aalonsopuig/Brutus_robot/Document/spmodules.png

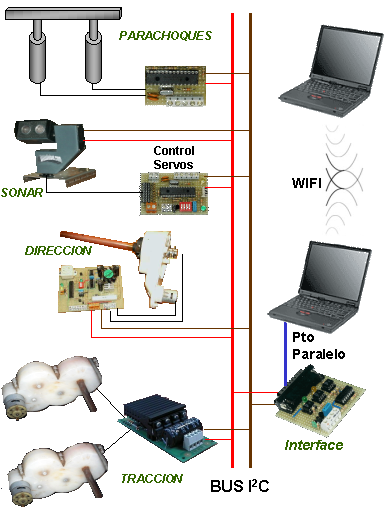
Document/spmodules.png
