aalonsopuig/Brutus_robot/Document/Ruso.jpg

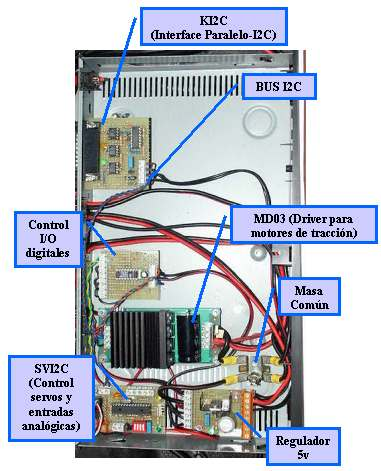
Document/Ruso.jpg
