aalonsopuig/Brutus_robot/Document/brutusprog.png

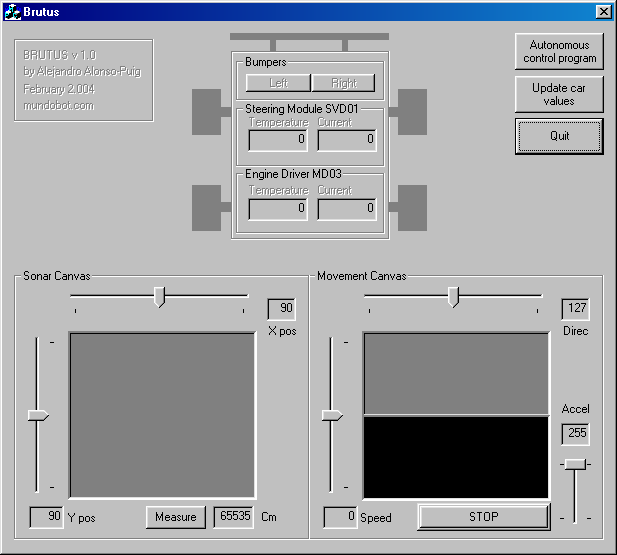
Document/brutusprog.png
