aalonsopuig/Brutus_robot/Document/finitos.png

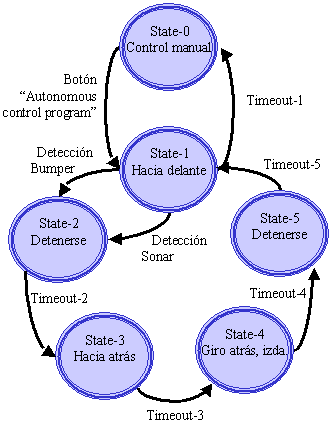
Document/finitos.png
