aalonsopuig/Brutus_robot/Document/InAction4b.jpg

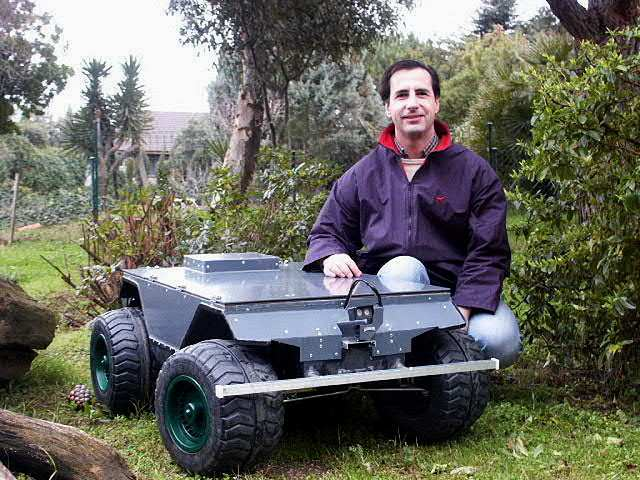
Document/InAction4b.jpg
