aalonsopuig/Brutus_robot/Document/Steering.jpg

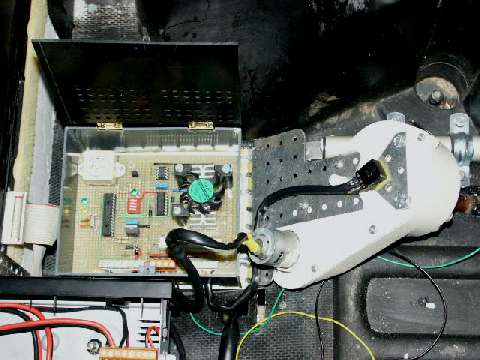
Document/Steering.jpg
