aalonsopuig/Brutus_robot/prog_Brutus_PC/Brutus.h

// Brutus.h : main header file for the BRUTUS application
// By Alejandro Alonso Puig
// February 2004
// mundobot.com
//
//

#if !defined(AFX_BRUTUS_H__4E5EDD65_274B_11D8_B526_00104BF1F258__INCLUDED_)
#define AFX_BRUTUS_H__4E5EDD65_274B_11D8_B526_00104BF1F258__INCLUDED_

#if _MSC_VER > 1000
#pragma once
#endif // _MSC_VER > 1000

#ifndef __AFXWIN_H__
	#error include 'stdafx.h' before including this file for PCH
#endif

#include "resource.h"		// main symbols

/////////////////////////////////////////////////////////////////////////////
// CBrutusApp:
// See Brutus.cpp for the implementation of this class
//

class CBrutusApp : public CWinApp
{
public:
	CBrutusApp();

// Overrides
	// ClassWizard generated virtual function overrides
	//{{AFX_VIRTUAL(CBrutusApp)
	public:
	virtual BOOL InitInstance();
	//}}AFX_VIRTUAL

// Implementation

	//{{AFX_MSG(CBrutusApp)
		// NOTE - the ClassWizard will add and remove member functions here.
		//    DO NOT EDIT what you see in these blocks of generated code !
	//}}AFX_MSG
	DECLARE_MESSAGE_MAP()
};


/////////////////////////////////////////////////////////////////////////////

//{{AFX_INSERT_LOCATION}}
// Microsoft Visual C++ will insert additional declarations immediately before the previous line.

#endif // !defined(AFX_BRUTUS_H__4E5EDD65_274B_11D8_B526_00104BF1F258__INCLUDED_)
