aalonsopuig/Brutus_robot/prog_Brutus_PC/StdAfx.h

// stdafx.h : include file for standard system include files,
//  or project specific include files that are used frequently, but
//      are changed infrequently
//

#if !defined(AFX_STDAFX_H__4E5EDD69_274B_11D8_B526_00104BF1F258__INCLUDED_)
#define AFX_STDAFX_H__4E5EDD69_274B_11D8_B526_00104BF1F258__INCLUDED_

#if _MSC_VER > 1000
#pragma once
#endif // _MSC_VER > 1000

#define VC_EXTRALEAN		// Exclude rarely-used stuff from Windows headers

#include <afxwin.h>         // MFC core and standard components
#include <afxext.h>         // MFC extensions
#include <afxdisp.h>        // MFC Automation classes
#include <afxdtctl.h>		// MFC support for Internet Explorer 4 Common Controls
#ifndef _AFX_NO_AFXCMN_SUPPORT
#include <afxcmn.h>			// MFC support for Windows Common Controls
#endif // _AFX_NO_AFXCMN_SUPPORT


//{{AFX_INSERT_LOCATION}}
// Microsoft Visual C++ will insert additional declarations immediately before the previous line.

#endif // !defined(AFX_STDAFX_H__4E5EDD69_274B_11D8_B526_00104BF1F258__INCLUDED_)
