aalonsopuig/Brutus_robot/prog_Brutus_PC/resource.h

//{{NO_DEPENDENCIES}}
// Microsoft Developer Studio generated include file.
// Used by Brutus.rc
//
#define IDD_BRUTUS_DIALOG               102
#define IDR_MAINFRAME                   128
#define IDC_CANVAS                      1000
#define IDC_STOP                        1001
#define IDC_Speed                       1002
#define IDC_Direc                       1003
#define IDC_AccelSlider                 1004
#define IDC_Accel                       1005
#define IDC_TempMD03_1                  1006
#define IDC_CurrMD03_1                  1007
#define IDC_UPDATE                      1008
#define IDC_TempSVD01                   1009
#define IDC_CurrSVD01                   1010
#define IDC_CANVAS3                     1012
#define IDC_SpeedSlider                 1015
#define IDC_DirecSlider                 1016
#define IDC_CANVAS2                     1019
#define IDC_ChkSonar                    1020
#define IDC_YSonar                      1021
#define IDC_XSonar                      1022
#define IDC_MovCanv                     1024
#define IDC_DistSonar                   1025
#define IDC_YSonarSlider                1026
#define IDC_XSonarSlider                1027
#define IDC_SonarCanv                   1028
#define IDC_BumpLeft                    1031
#define IDC_BumpRight                   1032
#define IDC_AUTO1                       1034
#define IDC_bum                         1035

// Next default values for new objects
// 
#ifdef APSTUDIO_INVOKED
#ifndef APSTUDIO_READONLY_SYMBOLS
#define _APS_NEXT_RESOURCE_VALUE        130
#define _APS_NEXT_COMMAND_VALUE         32771
#define _APS_NEXT_CONTROL_VALUE         1036
#define _APS_NEXT_SYMED_VALUE           101
#endif
#endif
